slburris/Projects-spinklercontroller/KiCAD/sprinklercontroller/sprinklercontroller.pdf

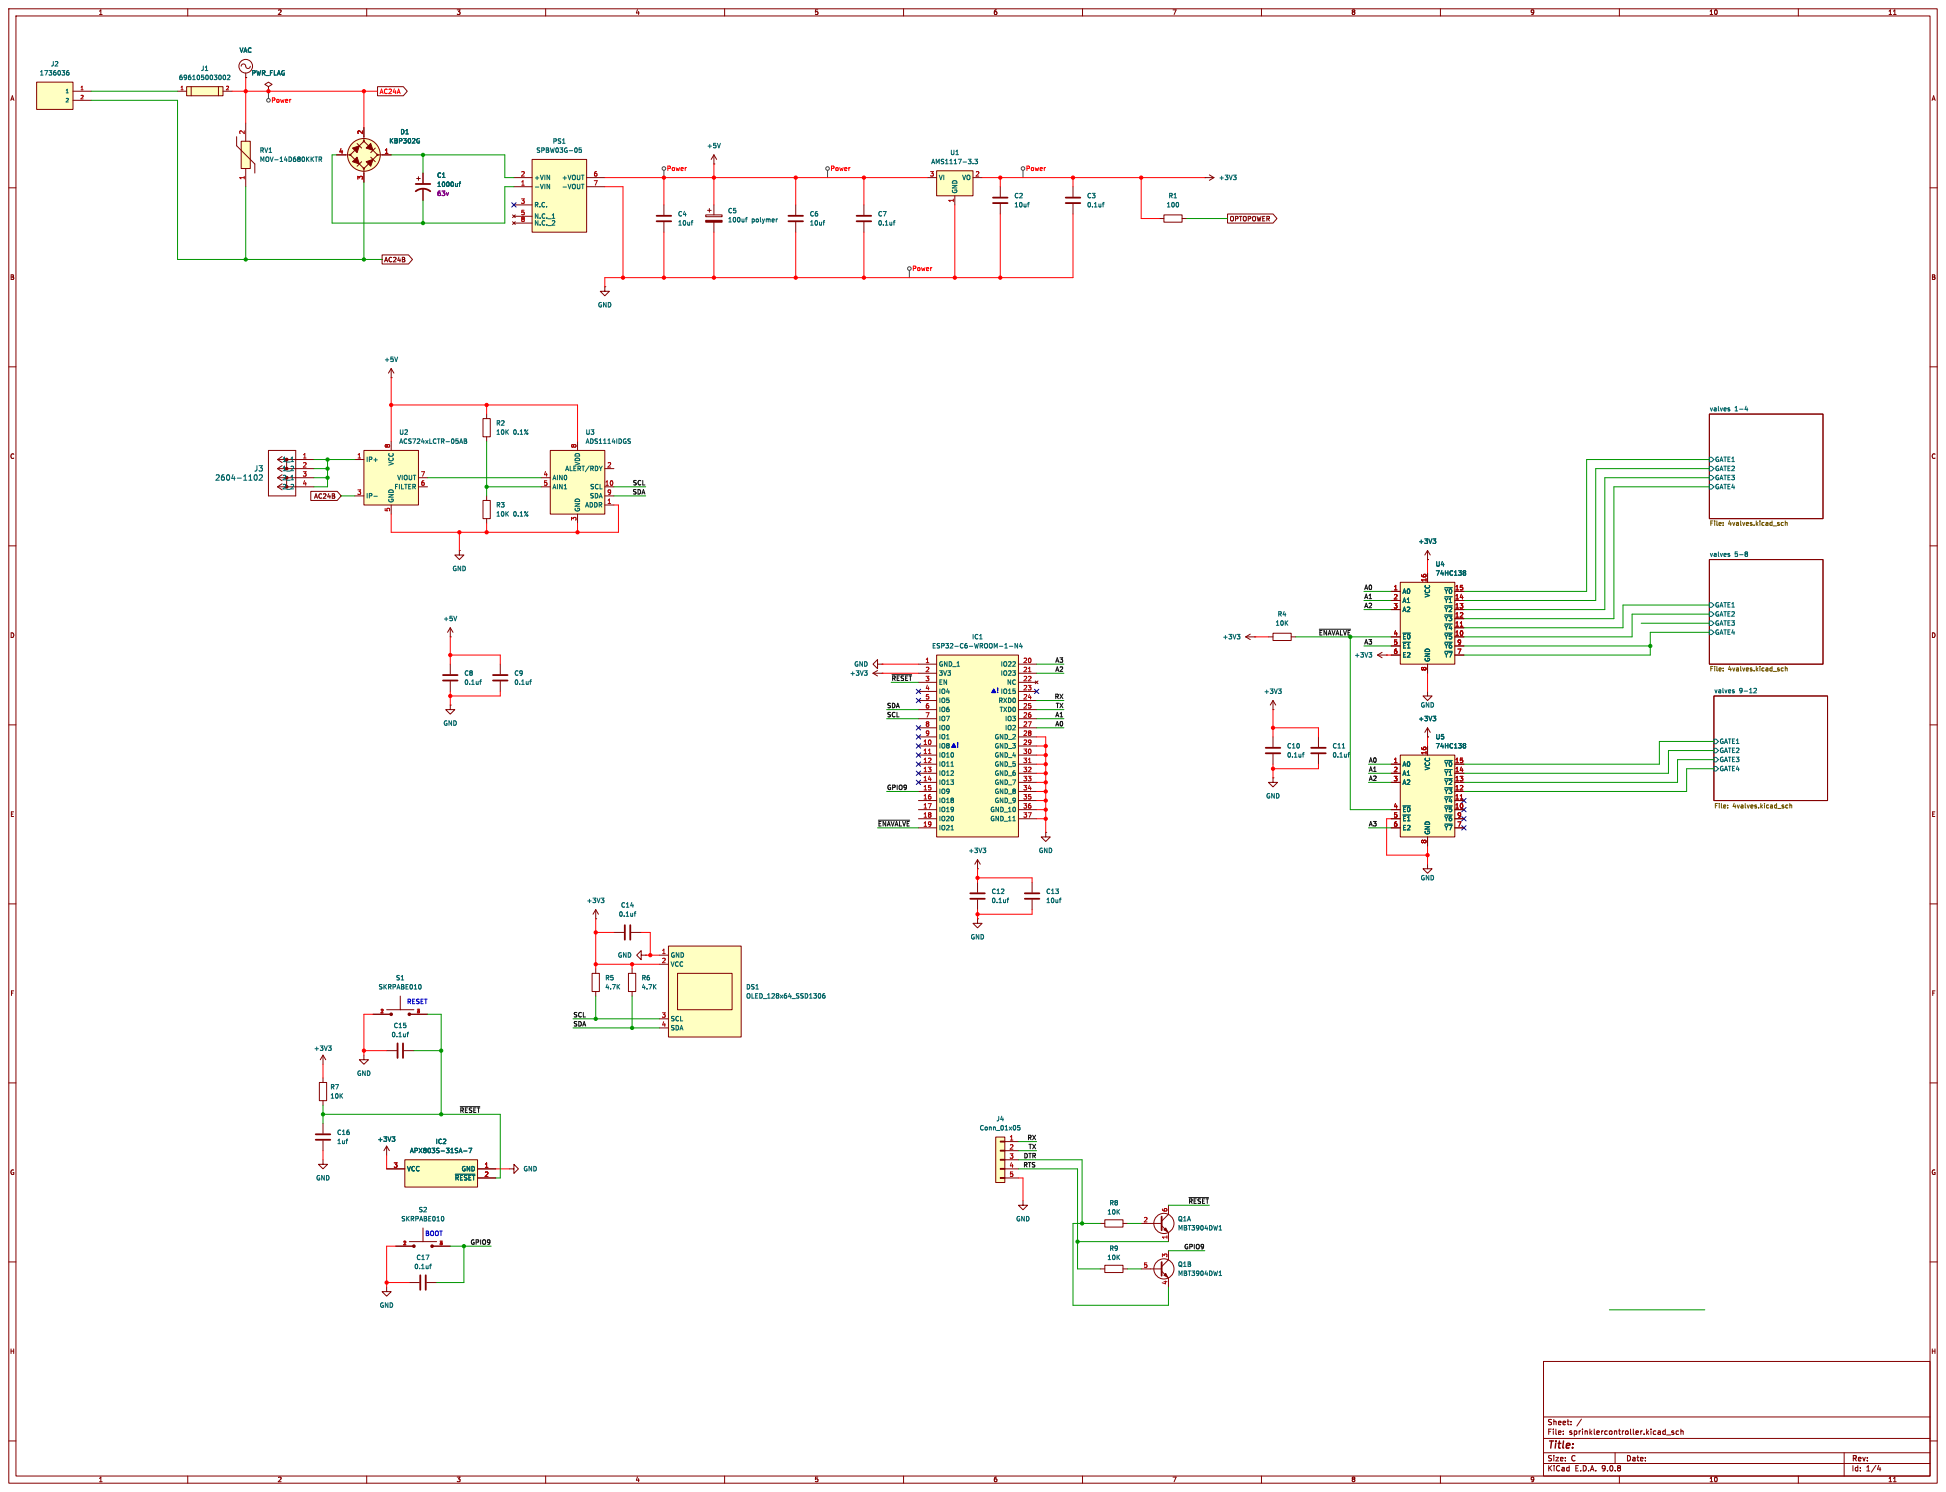
[picture p1: page 1]

3 ALERT/RDY 2 SCL 10 SDA 9 ADDR 1 U3ADS1114IDGS R2

Id: 1/4 Title: File: sprinklercontroller.kicad_sch Sheet: /

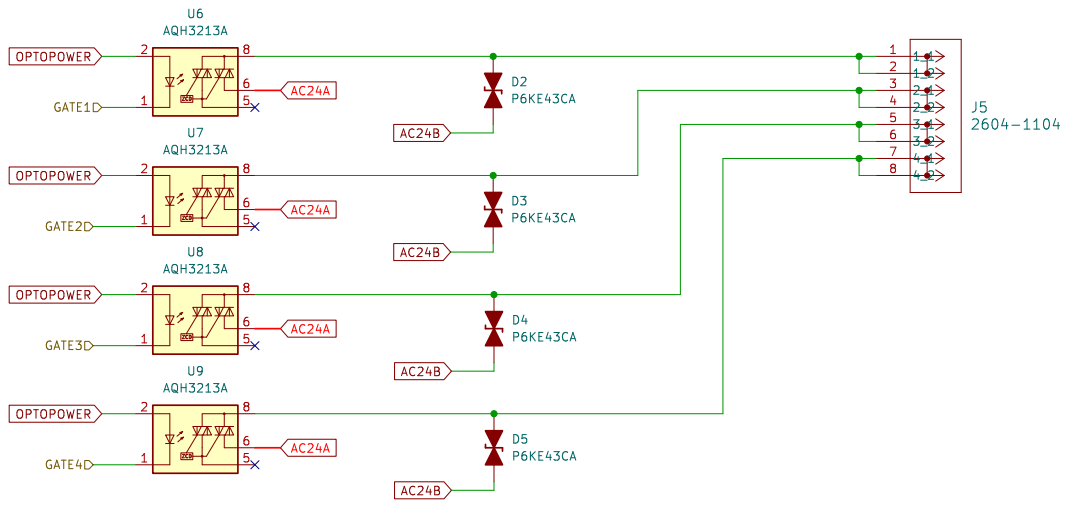
[picture p2: page 2]

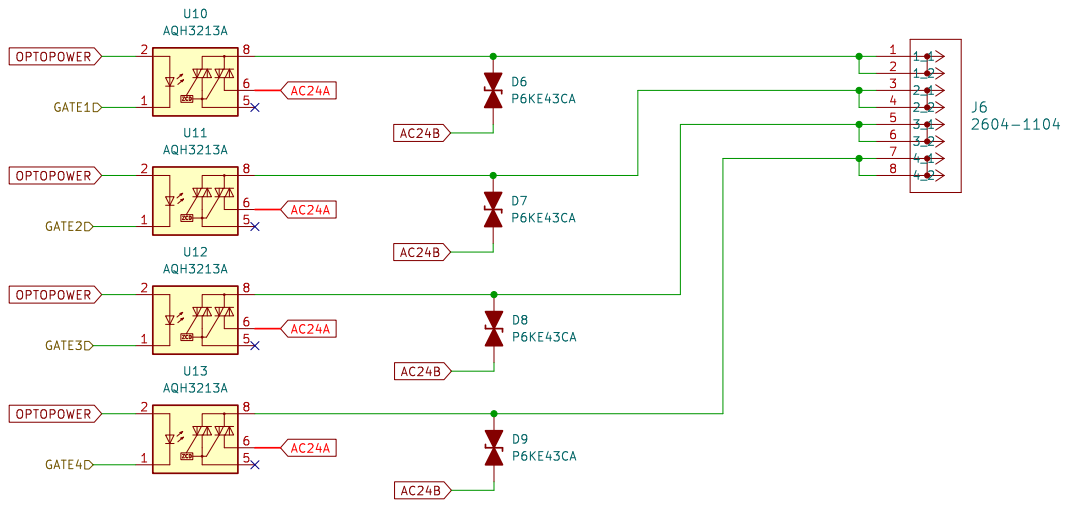
[picture p3: page 3]

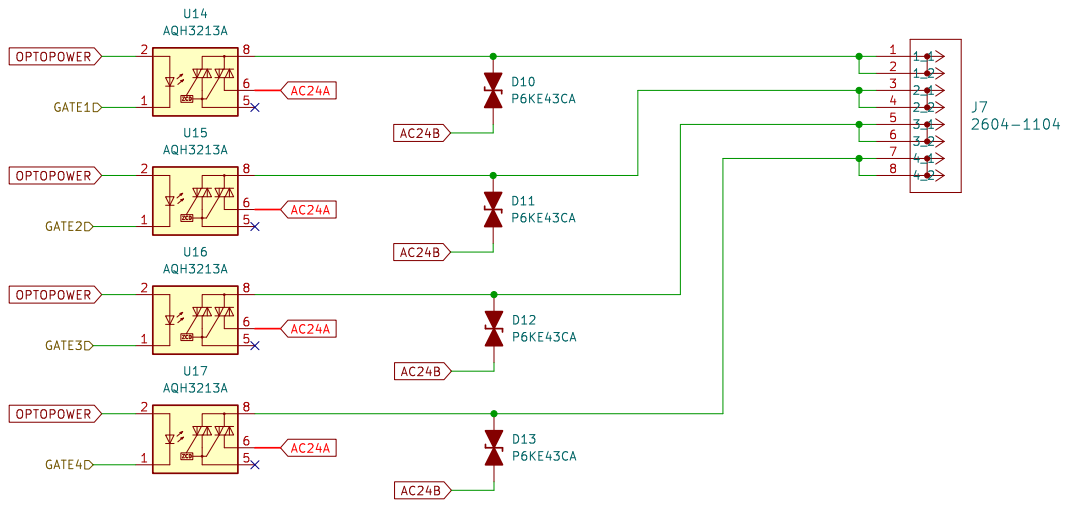
[picture p4: page 4]
