slburris/Projects-spinklercontroller/KiCAD/sprinklercontroller/sprinklercontroller.kicad_pcb

## KiCad design KiCAD/sprinklercontroller/sprinklercontroller.kicad_pcb (2026-05-02)

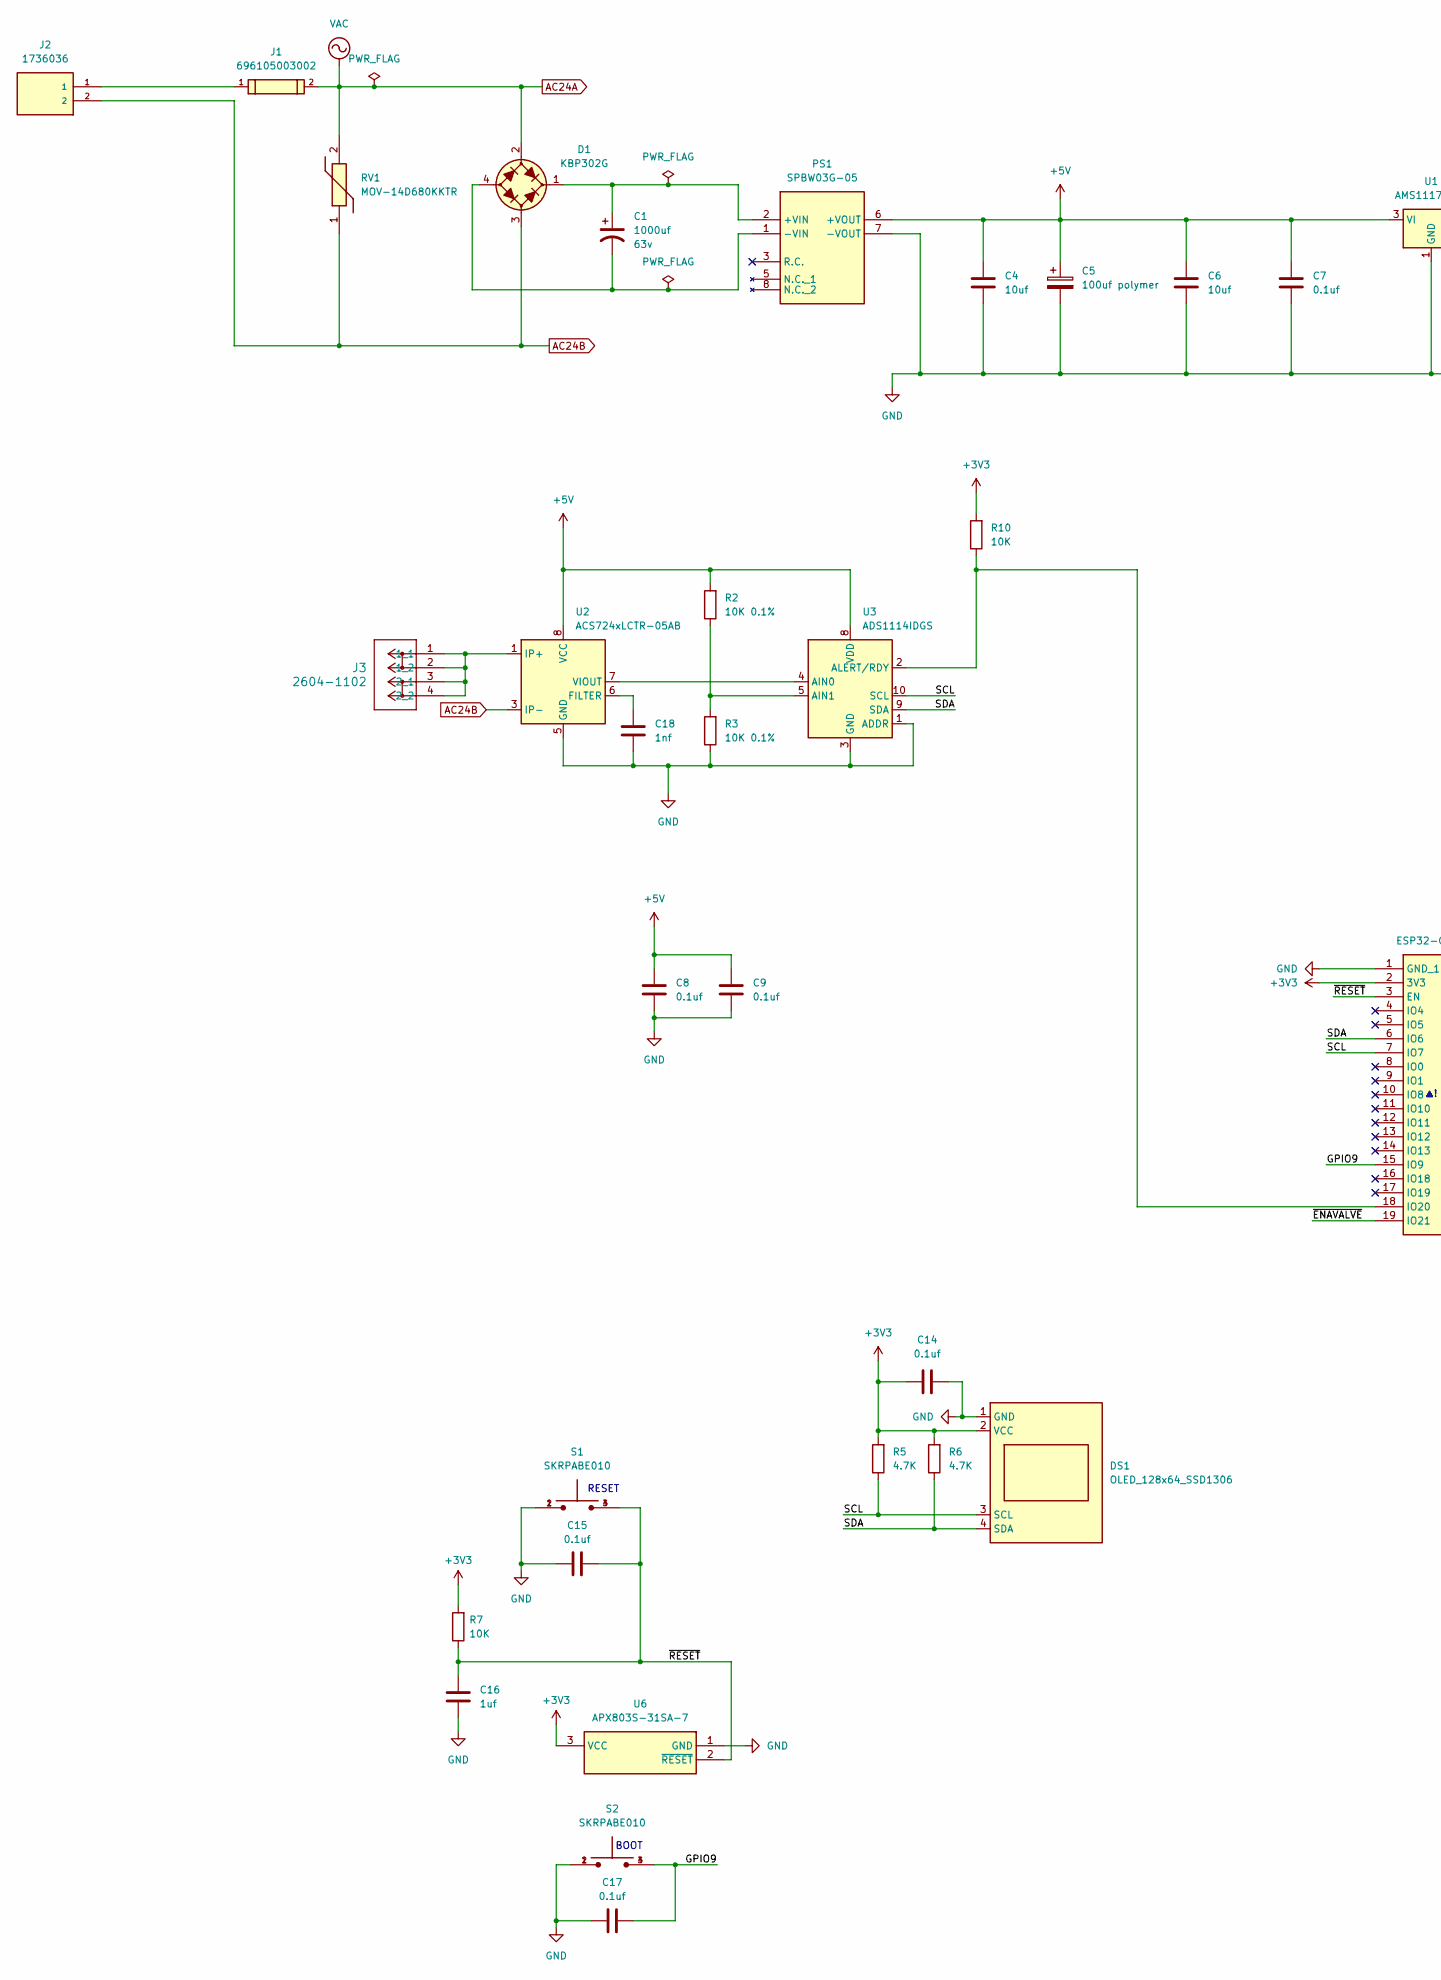
[picture p5: schematic sprinklercontroller.kicad_sch, part in row 1, column 1]

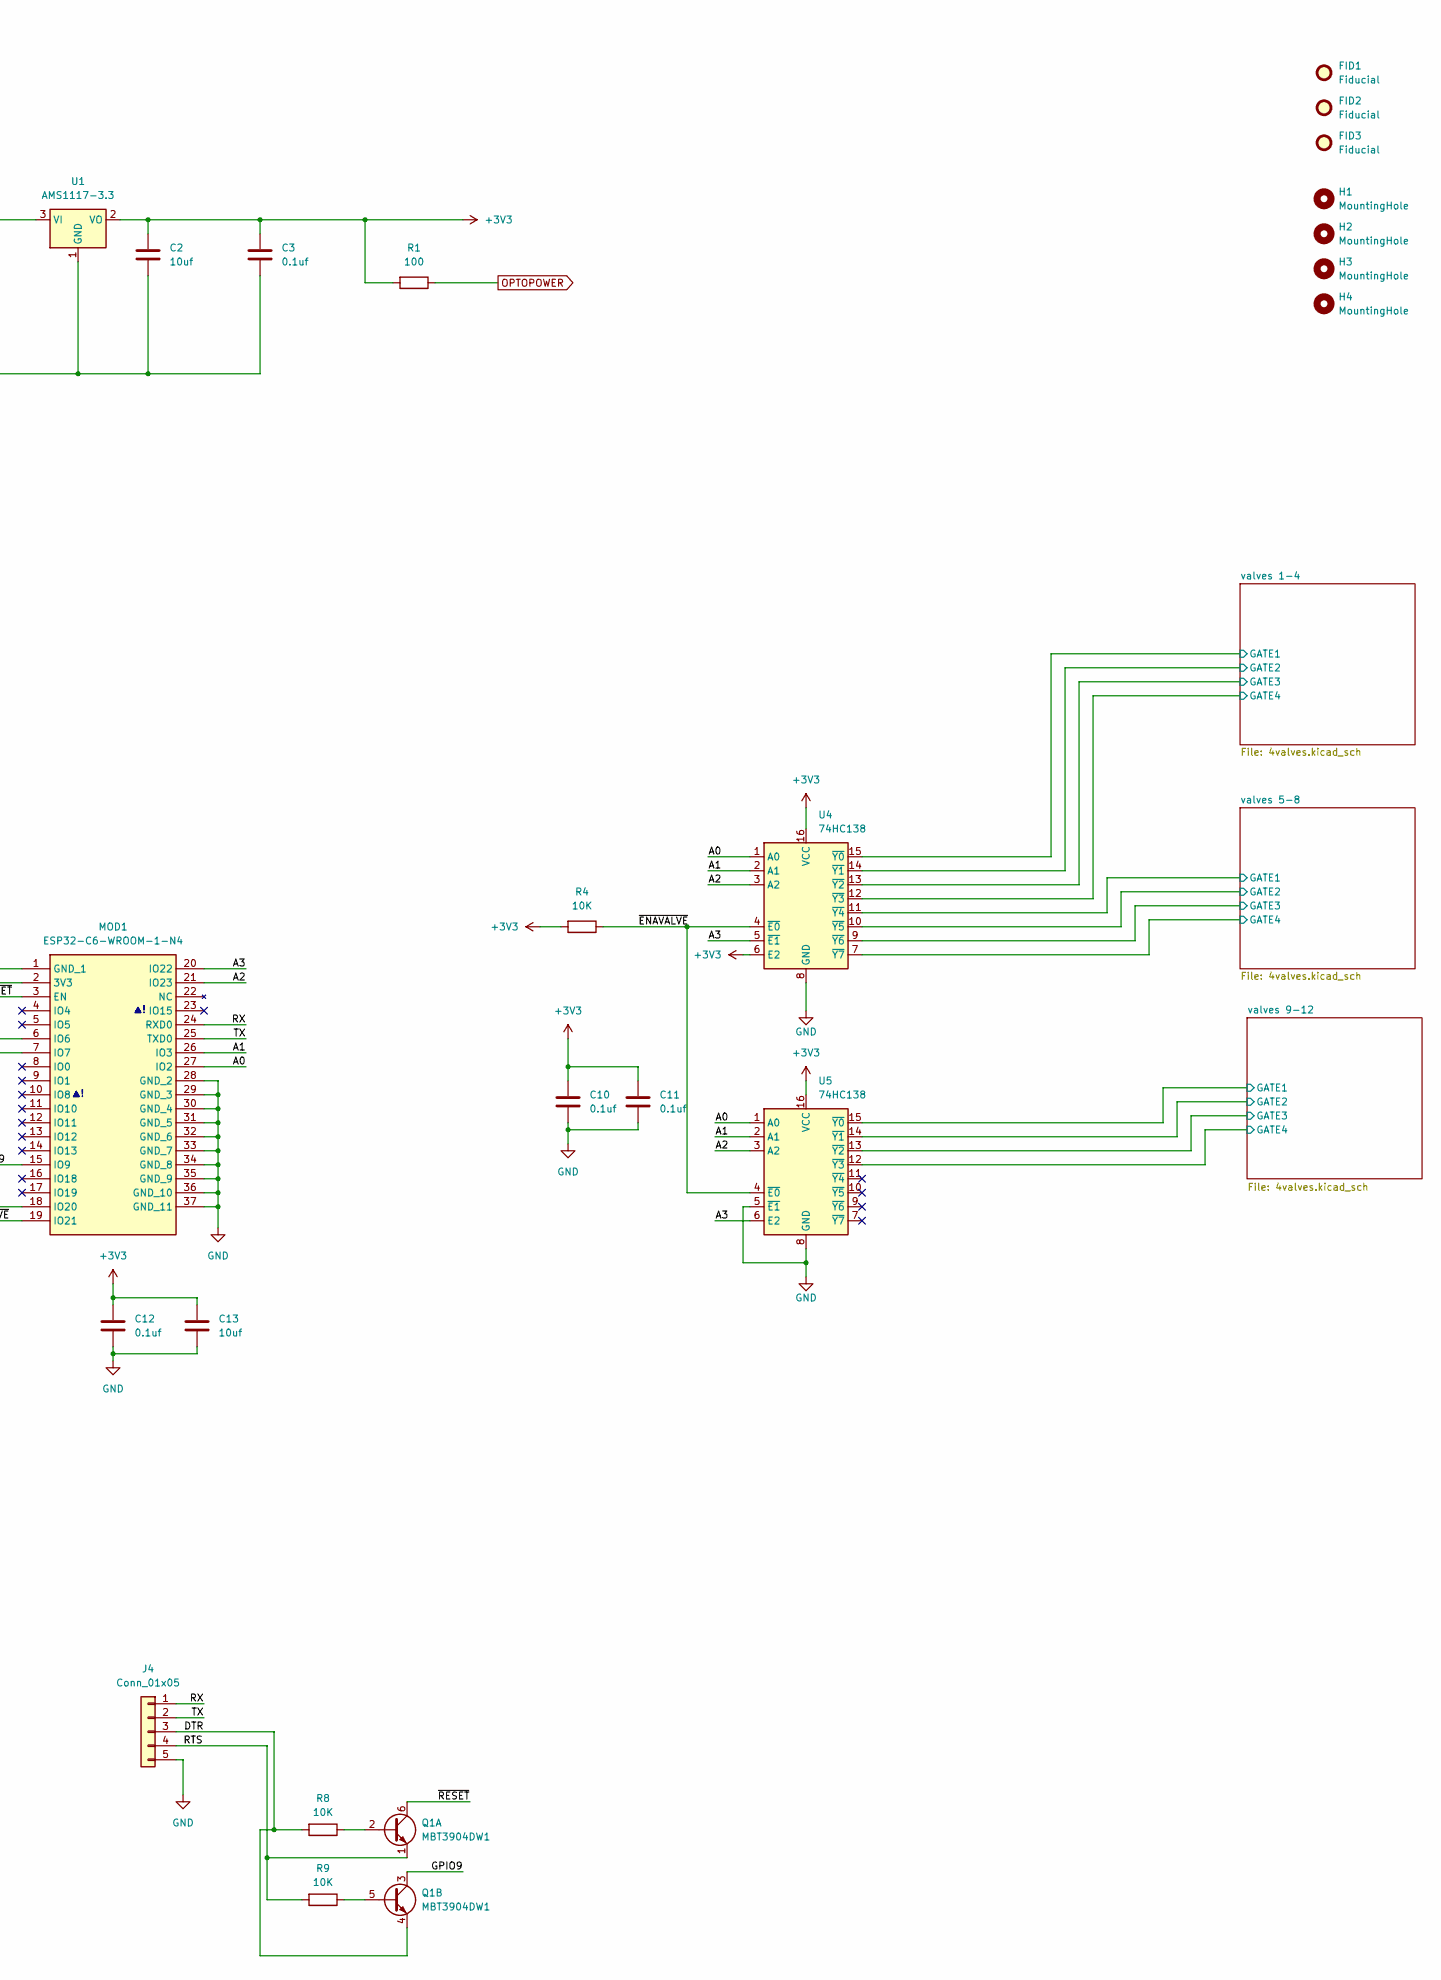
[picture p6: schematic sprinklercontroller.kicad_sch, part in row 1, column 2]

Parts:
C1: 1000uf; CP_Radial_D16.0mm_P7.50mm; Voltage 63v; Tolerance 100%
C2, C6, C13: 10uf; C_1206_3216Metric_Pad1.33x1.80mm_HandSolder; Part C2012X5R1V106K085AC
C3, C7, C8, C9, C10, C11, C12, C14, C15, C17: 0.1uf; C_0603_1608Metric_Pad1.08x0.95mm_HandSolder; Part CGA3E2X7R1H104K080AA
C4: 10uf; C_1206_3216Metric_Pad1.33x1.80mm_HandSolder
C5: 100uf polymer; CP_Radial_D5.0mm_P2.00mm
C16: 1uf; C_1206_3216Metric_Pad1.33x1.80mm_HandSolder
C18: 1nf; C_1206_3216Metric_Pad1.33x1.80mm_HandSolder; Part C2012X5R1V106K085AC
D1: KBP302G; Diode_Bridge_KBP
DS1: OLED_128x64_SSD1306
FID1, FID2, FID3: Fiducial; Fiducial_1mm_Mask2mm
H1, H2, H3, H4: MountingHole; MountingHole_3.2mm_M3
J1: 696105003002
J2: 1736036; PHOENIX_1736036
J3: 2604-1102; CONN2_2604-1102_WAG
J4: Conn_01x05; PinHeader_1x05_P2.54mm_Vertical
MOD1: ESP32-C6-WROOM-1-N4; ESP32C6WROOM1N4; Manufacturer_Part_Number ESP32-C6-WROOM-1-N4; Mouser Part Number 356-ESP32C6WROOM1N4
PS1: SPBW03G-05; SPBW03G05; Manufacturer_Part_Number SPBW03G-05; Mouser Part Number 709-SPBW03G-05
Q1: MBT3904DW1; SOT-363_SC-70-6
R1: 100; R_1206_3216Metric_Pad1.42x1.75mm_HandSolder
R2, R3: 10K 0.1%; R_1206_3216Metric_Pad1.42x1.75mm_HandSolder
R4, R10: 10K; R_1206_3216Metric_Pad1.42x1.75mm_HandSolder
R5, R6: 4.7K; R_1206_3216Metric_Pad1.42x1.75mm_HandSolder
R7, R8, R9: 10K; R_1206_3216Metric_Pad1.30x1.75mm_HandSolder
RV1: MOV-14D680KKTR; MOV14D680KKTR; Manufacturer_Part_Number MOV-14D680KKTR; Mouser Part Number 652-MOV-14D680KKTR
S1, S2: SKRPABE010; SW_SKRPABE010
U1: AMS1117-3.3; SOT-223-3_TabPin2
U2: ACS724xLCTR-05AB; SOIC-8_3.9x4.9mm_P1.27mm
U3: ADS1114IDGS; TSSOP-10_3x3mm_P0.5mm
U4, U5: 74HC138; SOIC-16_3.9x9.9mm_P1.27mm
U6: APX803S-31SA-7; SOT96P240X100-3N; Mouser Part Number 621-APX803S-31SA-7

Connections:
+3V3: C2.1, C3.1, C10.2, C11.2, C12.2, C13.1, C14.2, DS1.2 (VCC), MOD1.2 (3V3), R1.2, R4.2, R5.2, R6.2, R7.2, R10.2, U1.2 (VO), U4.6 (E2), U4.16 (VCC), U5.16 (VCC), U6.3 (VCC)
+5V: C4.1, C5.1, C6.1, C7.1, C8.2, C9.2, PS1.6 (+VOUT), R2.2, U1.3 (VI), U2.8 (VCC), U3.8 (VDD)
/A0: MOD1.27 (IO2), U4.1 (A0), U5.1 (A0)
/A1: MOD1.26 (IO3), U4.2 (A1), U5.2 (A1)
/A2: MOD1.21 (IO23), U4.3 (A2), U5.3 (A2)
/A3: MOD1.20 (IO22), U4.5 (~E1), U5.6 (E2)
/DTR: J4.3, Q1.4 (E2), R8.2
/GPIO9: C17.2, MOD1.15 (IO9), Q1.3 (C2), S2.3, S2.4
/RTS: J4.4, Q1.1 (E1), R9.2
/RX: J4.1, MOD1.24 (RXD0)
/SCL: DS1.3 (SCL), MOD1.7 (IO7), R5.1, U3.10 (SCL)
/SDA: DS1.4 (SDA), MOD1.6 (IO6), R6.1, U3.9 (SDA)
/TX: J4.2, MOD1.25 (TXD0)
/valves 1-4/GATE1: U4.15 (~Y0); also elsewhere on the board
/valves 1-4/GATE2: U4.14 (~Y1); also elsewhere on the board
/valves 1-4/GATE3: U4.13 (~Y2); also elsewhere on the board
/valves 1-4/GATE4: U4.12 (~Y3); also elsewhere on the board
/valves 5-8/GATE1: U4.11 (~Y4); also elsewhere on the board
/valves 5-8/GATE2: U4.10 (~Y5); also elsewhere on the board
/valves 5-8/GATE3: U4.9 (~Y6); also elsewhere on the board
/valves 5-8/GATE4: U4.7 (~Y7); also elsewhere on the board
/valves 9-12/GATE1: U5.15 (~Y0); also elsewhere on the board
/valves 9-12/GATE2: U5.14 (~Y1); also elsewhere on the board
/valves 9-12/GATE3: U5.13 (~Y2); also elsewhere on the board
/valves 9-12/GATE4: U5.12 (~Y3); also elsewhere on the board
/~ENAVALVE: MOD1.19 (IO21), R4.1, U4.4 (~E0), U5.4 (~E0)
/~RESET: C15.2, C16.1, MOD1.3 (EN), Q1.6 (C1), R7.1, S1.3, S1.4, U6.2 (~RESET)
AC24A: D1.2 (1), J1.2, RV1.2; also elsewhere on the board
AC24B: D1.3 (2), J2.2, RV1.1, U2.3 (IP-), U2.4 (IP-); also elsewhere on the board
GND: C2.2, C3.2, C4.2, C5.2, C6.2, C7.2, C8.1, C9.1, C10.1, C11.1, C12.1, C13.2, C14.1, C15.1, C16.2, C17.1, C18.2, DS1.1 (GND), J4.5, MOD1.1 (GND_1), MOD1.28 (GND_2), MOD1.29 (GND_3), MOD1.30 (GND_4), MOD1.31 (GND_5), MOD1.32 (GND_6), MOD1.33 (GND_7), MOD1.34 (GND_8), MOD1.35 (GND_9), MOD1.36 (GND_10), MOD1.37 (GND_11), PS1.7 (-VOUT), R3.1, S1.1, S1.2, S2.1, S2.2, U1.1 (GND), U2.5 (GND), U3.1 (ADDR), U3.3 (GND), U4.8 (GND), U5.5 (~E1), U5.8 (GND), U6.1 (GND)
unnamed: C1.1, D1.1 (+), PS1.2 (+VIN)
unnamed: C1.2, D1.4 (-), PS1.1 (-VIN)
unnamed: J1.1, J2.1
unnamed: J3.1 (1_1), J3.2 (1_2), J3.3 (2_1), J3.4 (2_2), U2.1 (IP+), U2.2 (IP+)
unnamed: MOD1.18 (IO20), R10.1, U3.2 (ALERT/RDY)
unnamed: Q1.2 (B1), R8.1
unnamed: Q1.5 (B2), R9.1
unnamed: C18.1, U2.6 (FILTER)
unnamed: U2.7 (VIOUT), U3.4 (AIN0)
unnamed: R2.1, R3.2, U3.5 (AIN1)
OPTOPOWER: R1.1; also elsewhere on the board

Notes on the sheet:
RESET
BOOT

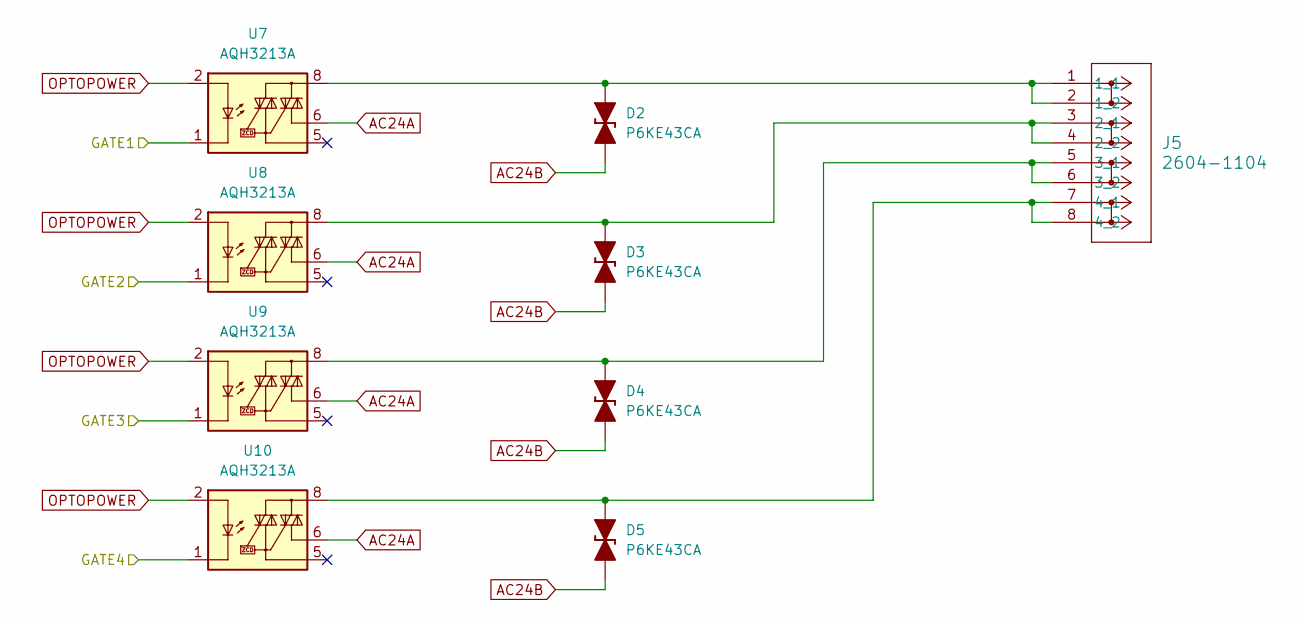
[picture p7: schematic 4valves.kicad_sch]

Parts:
D2, D3, D4, D5: P6KE43CA; D_DO-27_P5.08mm_Vertical_KathodeUp
J5: 2604-1104; CONN4_2604-1104_WAG
U7, U8, U9, U10: AQH3213A; SSO-7-8_6.4x9.78mm_P2.54mm

Connections:
/valves 1-4/GATE1: U7.1, U7.3, U7.4; also elsewhere on the board
/valves 1-4/GATE2: U8.1, U8.3, U8.4; also elsewhere on the board
/valves 1-4/GATE3: U9.1, U9.3, U9.4; also elsewhere on the board
/valves 1-4/GATE4: U10.1, U10.3, U10.4; also elsewhere on the board
AC24A: U7.6, U8.6, U9.6, U10.6; also elsewhere on the board
AC24B: D2.1 (K), D3.1 (K), D4.1 (K), D5.1 (K); also elsewhere on the board
unnamed: D2.2 (A), J5.1 (1_1), J5.2 (1_2), U7.8
unnamed: D3.2 (A), J5.3 (2_1), J5.4 (2_2), U8.8
unnamed: D4.2 (A), J5.5 (3_1), J5.6 (3_2), U9.8
unnamed: D5.2 (A), J5.7 (4_1), J5.8 (4_2), U10.8
OPTOPOWER: U7.2, U8.2, U9.2, U10.2; also elsewhere on the board

Parts of its further copies:
D6, D7, D8, D9, D10, D11, D12, D13: P6KE43CA; D_DO-27_P5.08mm_Vertical_KathodeUp
J6, J7: 2604-1104; CONN4_2604-1104_WAG
U11, U12, U13, U14, U15, U16, U17, U18: AQH3213A; SSO-7-8_6.4x9.78mm_P2.54mm

Connections of its further copies:
/valves 5-8/GATE1: U11.1, U11.3, U11.4; also elsewhere on the board
/valves 5-8/GATE2: U12.1, U12.3, U12.4; also elsewhere on the board
/valves 5-8/GATE3: U13.1, U13.3, U13.4; also elsewhere on the board
/valves 5-8/GATE4: U14.1, U14.3, U14.4; also elsewhere on the board
/valves 9-12/GATE1: U15.1, U15.3, U15.4; also elsewhere on the board
/valves 9-12/GATE2: U16.1, U16.3, U16.4; also elsewhere on the board
/valves 9-12/GATE3: U17.1, U17.3, U17.4; also elsewhere on the board
/valves 9-12/GATE4: U18.1, U18.3, U18.4; also elsewhere on the board
AC24A: U11.6, U12.6, U13.6, U14.6, U15.6, U16.6, U17.6, U18.6; also elsewhere on the board
AC24B: D6.1 (K), D7.1 (K), D8.1 (K), D9.1 (K), D10.1 (K), D11.1 (K), D12.1 (K), D13.1 (K); also elsewhere on the board
unnamed: D6.2 (A), J6.1 (1_1), J6.2 (1_2), U11.8
unnamed: D7.2 (A), J6.3 (2_1), J6.4 (2_2), U12.8
unnamed: D8.2 (A), J6.5 (3_1), J6.6 (3_2), U13.8
unnamed: D9.2 (A), J6.7 (4_1), J6.8 (4_2), U14.8
unnamed: D10.2 (A), J7.1 (1_1), J7.2 (1_2), U15.8
unnamed: D11.2 (A), J7.3 (2_1), J7.4 (2_2), U16.8
unnamed: D12.2 (A), J7.5 (3_1), J7.6 (3_2), U17.8
unnamed: D13.2 (A), J7.7 (4_1), J7.8 (4_2), U18.8
OPTOPOWER: U11.2, U12.2, U13.2, U14.2, U15.2, U16.2, U17.2, U18.2; also elsewhere on the board

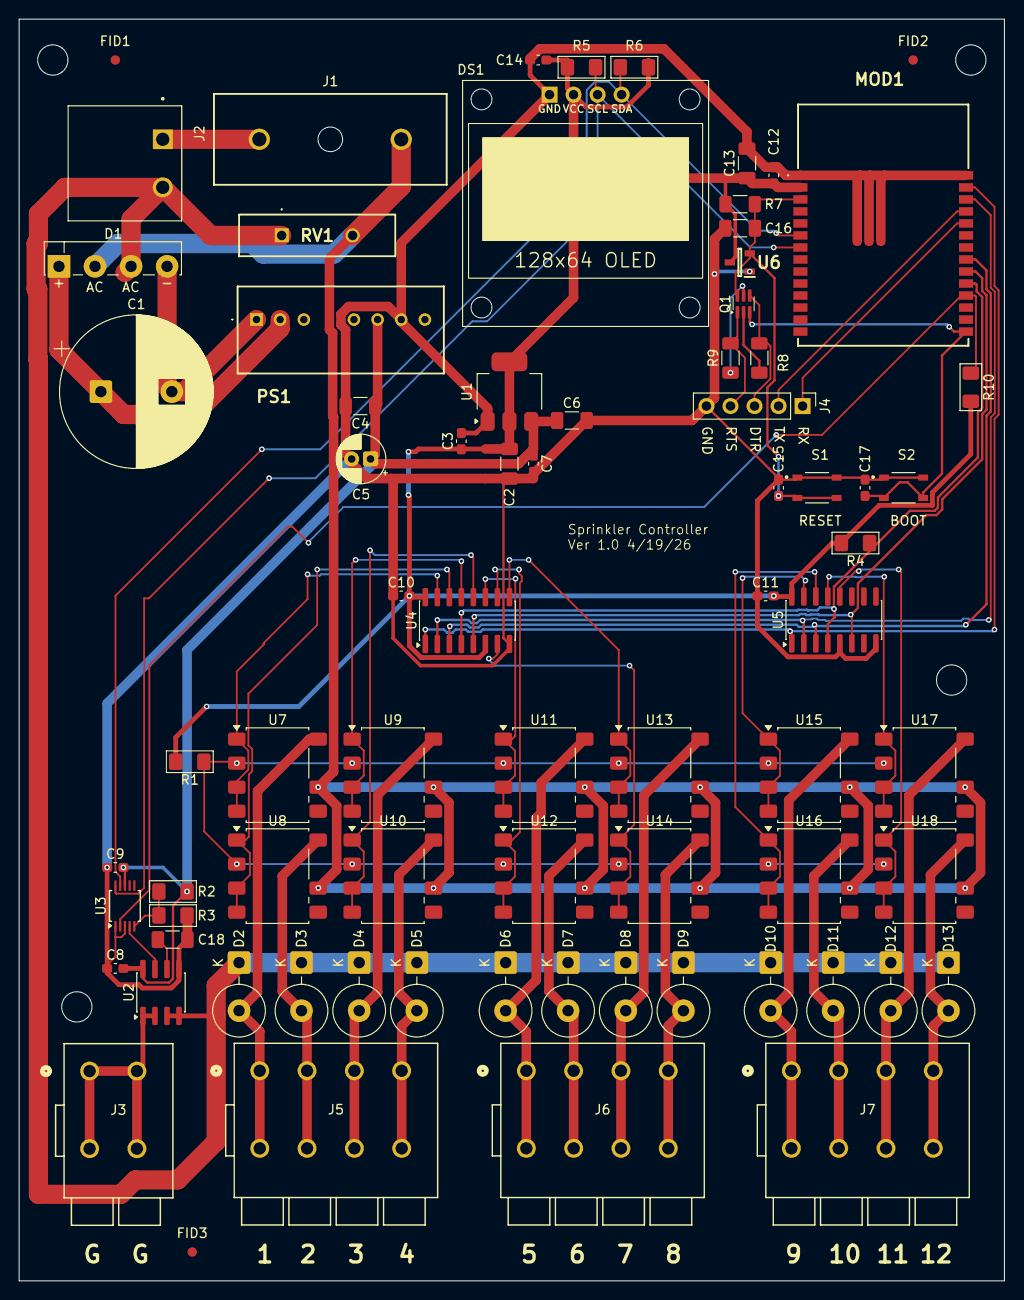
[picture p8: board sprinklercontroller.kicad_pcb from above]

Board: 2 copper layers, 104.1 x 133.4 mm, 80 parts (0 on the bottom side), 53 nets.
